hangchengliu/wake-sleep-box/ESP32S3 Korvo 2 V3开发板介绍 酷世DIY.md

# ESP32S3 Korvo 2 V3开发板介绍 酷世DIY

# [一、硬件简介](https://icnynnzcwou8.feishu.cn/wiki/IB7Gw8iQmi38vskElv6cDtHJn3c)

文档教程：<https://github\\.com/Kevincoooool/esp\\-idf\\-docs>

<https://gitee\\.com/Kevincoooool/esp\\-idf\\-docs>



除此之外每个例程的readme.md文档也可以看看

开发板3D文件和外壳3D文件：

[KS_S3_KORVO_V4.step]

[Korvo上盖.stl]

[Korvo下盒子.stl]

开发板介绍视频：

[VID_20260630_152118.mp4]

# 二、必看编译过程！！！！

# [Windows搭建 ESP IDF 5.3.2开发环境以及编译小智](https://icnynnzcwou8.feishu.cn/wiki/JEYDwTTALi5s2zkGlFGcDiRknXf)

Korvo板烧录小智固件可以选1.9.4稳定版 或者最新的2.2.3以上

官方固件：<https://github\\.com/78/xiaozhi\\-esp32/releases/download/v2\\.2\\.6/v2\\.2\\.6\\\_esp32s3\\-korvo2\\-v3\\.zip>



烧录固件的工具：

[esp32-flasher.exe]

查看运行日志的工具：

[ESP32串口助手.exe]

以下是带小智摄像头预览的固件，唤醒词是小白小白：

[merged-binary.bin]

如果遇到无法下载的情况请安装驱动：

Mac版驱动:

[CH341SER_MAC.ZIP]

Windows版驱动：

[CH341SER.zip]

音频对讲例子：<https://github\\.com/espressif/esp\\-adf/tree/release/v2\\.x/examples/protocols/esp\\-rtc>

> # [AI对话例程](https://icnynnzcwou8.feishu.cn/wiki/PPvrwrTCRi4U5PkKzEUc0qT3nre) 虾哥的小智AI
>
> # 改唤醒词参考：[关于唤醒词更改及配置操作步骤](https://rcnv1t9vps13.feishu.cn/wiki/H4dywK6ucigEtykKmm3cmZ7Dnog)
>
> # [需要使用参考小智AI百科全书](https://ccnphfhqs21z.feishu.cn/wiki/F5krwD16viZoF0kKkvDcrZNYnhb)

> 鼠标悬浮在空白行左侧，点击“**+**”插入“**信息收集**”小应用。[了解更多](https://www.feishu.cn/hc/zh-CN/articles/490019170235?from=in_ccm_template_docs)
