hangchengliu/wake-sleep-box/HACK For LIFE｜WTCC参赛指南·硬件篇.md

# HACK For LIFE｜WTCC参赛指南·硬件篇

> 选手阅读稿 ｜硬件篇 · 2026年10月18日。根据组委会宣发稿、已确认事项、物料图片、TiDB技术资料及官方文档整理；当前先完成本地硬件篇。现场提供设备按组委会清单列明；每队借用分配及其他未列明的赛事安排另行补充。除明确标注的规定外，本文中的技术建议不等于比赛强制要求。

**联合赞助伙伴｜TiDB**

感谢TiDB为本次活动提供资金与硬件支持。活动提供TiDB SDK及配套接入资料，参赛开发环境默认按接入TiDB能力准备。请各队将SDK安装或接入验证列入开工步骤，再围绕自己的生活场景开发功能。本文沿用活动“TiDB SDK”的称呼；具体软件包、版本与安装位置以现场适配教程为准。

**特别感谢以下造物伙伴**

地瓜机器人

进迭时空

拓竹科技杭州西湖文三路授权专营店

## 出发前，先看这六件事

1. **时间地点：** 10月22—25日，上海西岸国际会展中心；每队2—4人。
2. **我们提供：** X5、Pico- ITX、ESP32相关硬件、STM32套件、USB摄像头，以及打印和装配资源，详细数量见下一张设备表。
3. **你要带：** 笔记本和充电器；使用开发板本地桌面时，自带显示器、键盘、鼠标及显示线和电源。现场没有显示器和键鼠。
4. **建议先选定开发板，完成开发环境配置，再接入 TiDB SDK。硬件选型时，请综合考虑功能需求、硬件成本与实际效益。：**TiDB SDK安装/接入验证参考[TIDB 使用以及案例文档](https://feishu.doubao.com/wiki/DkW6woXxfidrd7knLQDcrF25nbe)；再按视觉、板端AI或动作控制需求阅读对应板卡章节。
5. **现场禁止焊接：** 需要焊接的部分赛前完成，现场采用免焊连接。
6. **每天18:00闭馆：** 不提供住宿；带离硬件须登记获准，打印机等公共设备留在现场。

## 活动速览

**HACK For LIFE，用AI，重新设计人的一生。** 2026年10月22—25日，在上海西岸国际会展中心，用四天做出一个可以运行、可以触摸、可以现场演示的AI硬件原型。

可以个人报名，提前组队或在选手群、现场寻找队友；每队2—4人。可以带已有设备、代码、设计文件或半成品参赛，报名时须如实说明赛前完成情况；评审关注比赛期间完成的有效增量，成熟产品评奖资格以正式规则为准。

| 赛道 | 关注的问题方向 |
|-|-|
| BEGIN｜生命初启 | 孕育、儿童成长、学习教育、亲子与创造力 |
| LIVE｜正在生活 | 成年后的工作、家庭、社交、兴趣、创作与出行 |
| BLOOM｜人生再启 | 退休后的再学习、兴趣、运动、社交、陪伴与第二人生 |
| BEYOND｜数字生命 | 记忆与数字遗产、数字分身、代际传承、纪念与数据权利 |

赛道帮助你选择生活问题，硬件根据项目需要选择，不按某一家赞助商划分赛道。涉及儿童、健康或逝者资料时，应取得相应授权并尊重数据权利。

### 四天怎么推进

- 第一天：先进入WTCC展馆观察真实使用场景，中午回四楼整理观察、选择具体问题；下午确定赛题、组队并开始制作。
- 第二、三天：制作、联调、测试和删减功能，优先保留关键体验。详细时间表待公布。
- 第四天下午：Demo Day，实物展示并接受现场使用检验。具体报到、提交和展示时刻待公布。

### 每天离场前

场馆每天18:00闭馆，不提供住宿。闭馆后可带个人设备及**经登记允许外借**的硬件套件在场外继续开发；3D打印机等公共设备不得带离。离场前备份代码和模型、记录启动步骤，按工作人员要求处理打印任务与设备电源。

活动期间每天提供中餐

零食、饮料和矿泉水不限量供应。

项目可通过Opendev API Key使用主流模型；领取入口、模型清单与调用限制仍需组委会补充，不等于无需账号或任何并发均可使用。

## 1. TiDB联合赞助开发支持｜SDK与硬件Agent接入

[TIDB 使用以及案例文档](https://feishu.doubao.com/wiki/DkW6woXxfidrd7knLQDcrF25nbe)

## 我们提供哪些设备

现场准备了开发板、摄像头、传感器与执行器、3D打印设备，以及原型装配工具。你可以按项目需求申请使用，项目不可替代的核心元件建议自行携带。

**下表为组委会提供的设备与物料，总量不是每队配额。** 按项目需求申请使用，申请方式和每队配额另行公布。

### 开发板与智能硬件

| 我们准备的设备 | 当前清单数量 | 适合做什么 | 配套与使用说明 |
|-|-|-|-|
| A 板:ESP32-S3 Korvo 2V3开发板+四路舵机驱动板(感谢TiDB赞助) | 8套 | 语音交互机器人、桌面AI助手、可动装置;可结合传感器和舵机，实现感知、对话与动作联动。 | 配套四路舵机驱动板，可扩展舵机及传感器。可使用ailyBlockly图形化编程，或通过VS Code开发;结合Agent_link接入Agent，实现数据上报与指令控制。舵机需按实际型号配置供电与接线。 |
| B板:ROROLEE智能硬件(感谢TiDB赞助) | 10台 | AI语音伙伴、互动角色、随身语音助手等，适合以对话为核心的创意项目。 | 采用BLE语音方案，通过配套手机App与Agent通信。使用前需安装配套App、完成蓝牙连接及Agent 配置，也可自已开发接入TidbAgent平台或开发配套App |
| C板:微雪ESP32-S3-ePaper-3.97黑白墨水屏开发板(感谢TiDB赞助) | 6台 | AI桌面信息牌、电子工牌、日程与待办看板、文字回复展示、传感器数据看板。 | 原表主控名称“ESP32S31”待实物核对，屏幕规格与驱动待确认 |
| 14类传感器及交互模块(感谢TiDB赞助) | 每类5个，共70个 | 环境感知、人体与动作检测、压力与颜色识别，以及灯光、声音、遥控和旋钮交互，可组合制作智能装置。 | 包含薄膜压力、光照、气压温度、人体红外、红外测距、雨滴、蜂鸣器、RGB灯环、摇杆、六轴运动、颜色检测、红外遥控、旋转编码器、心率脉搏模块。选手可按创意选用一种或多种，连接前核对供电电压、接口和引脚。 |
| 地瓜机器人RDK X5开发套装  
（感谢地瓜机器人赞助） | 10套 | 摄像头识别、视觉交互、机器人感知 | 10个板卡10个电源10个SD卡；供电接法由设备台确认，借用后归还 |
| 进迭时空Pico- ITX（感谢进迭时空赞助） | 15套 | RISC-V板端AI应用与原型开发 | 15个开发板，15个 电源适配器+typeC |
| STM32F103C8T6入门套件 | 16套 | 传感器采集、灯光、舵机和电机控制 | 含最小系统板、下载器、USB转TTL及多类模块，按实际发放内容清点 |

### 摄像头、模块与电子配件

| 我们准备的物料 | 提供数量 | 主要内容与用途 |
|-|-|-|
| USB摄像头 | 16个 | 720P无畸变、60°视角摄像头模组，USB连接，用于开发板视觉识别 |
| 传感器与输入模块 | 16套配套模块组（含在16套STM32套件内） | 光敏、热敏、红外、陀螺仪、旋转编码器、按键、电位器等 |
| 显示与输出模块 | 16套配套模块组（含在16套STM32套件内） | OLED、蜂鸣器、LED、SG90舵机、直流电机及驱动模块等；电机通过驱动与合适电源使用 |
| 连接与基础电子配件 | 16套配套材料（含在16套STM32套件内） | 面包板、杜邦线、跳线、电阻、鳄鱼夹等，采用免焊连接 |

上述三类模块和配件是同一批16套STM32套件的组成部分，不另加为48套独立设备；每套散件数量按套件配置。

### 3D打印与装配工具

| 我们提供的资源 | 数量或配置 | 用途与规则 |
|-|-|-|
| 3D打印机 | **共5台：**  
2 台A1  
1 台X2D  
1 台P2S  
1 台H2D | 共享制作外壳、支架和原型零件，公共设备不可带离场馆 |
| PETG打印耗材 | PETG囤货版，3套，每套10卷，共30卷 | 供现场3D打印使用，由打印工位安排 |
| 3D工具套装 | 16套，得力水口钳＋尖嘴钳等模型处理工具 | 打印模型修整与装配使用 |
| 得力热胶枪胶棒套装 | 16套，每套40W至尊胶枪＋30根胶棒 | 用于原型粘合固定，避免烫伤 |

**现场禁止焊接。** 如需焊接排针、连接器或其他部件，请在到场前完成。

### 3D打印如何排班（拟定流程，发布前由组委会落实）

5台打印机由打印工位统一管理，采用任务登记与排队使用；不按固定“几队一台”分配，也不让队伍长期占机。以下为本稿拟定流程，登记渠道与负责人确定后发布执行。

1. 队伍提交名称、联系人、模型文件、尺寸、数量、用途和期望完成时间；建议附预览图。
2. 打印负责人检查模型、材料和切片，估算用时后安排机器与时段。优先打印验证核心功能的小件，大件或长任务与负责人协商拆分。
3. 记录排班与任务状态，队伍按通知取件、试装；修改或重打重新登记，不直接覆盖其他队伍任务。
4. 临时取消及时告知，空出的时段继续安排排队任务。每日18:00闭馆前由负责人确认任务和断电安排，跨闭馆打印不得自行决定。

登记入口、文件格式要求、单次任务时长与材料限制由组委会另行公布；不承诺提交后立即开打或固定交付时刻。

### 现场设备之外，你需要带什么

建议每队自带**笔记本电脑、充电器、显示器、键盘、鼠标和对应线材**。X5准备HDMI连接，K3准备DP连接；显示器也要带电源。**现场不提供显示器、键盘和鼠标，请自行携带。**使用ROROLEE标准路径还需兼容手机。详细清单见第6节。

如果对网络有较高需求可带扩展坞，场地也支持网线联网

模型API及TiDB Agent Stack等属于软件服务资源，领取方式与权限另行说明，不计入硬件套装。

## 3. 第一次参加，先看这一段

你需要做的是：围绕一个具体问题，做出能现场演示的作品。先让一个核心功能跑通，再增加外壳、动作和界面。

例如：摄像头看到物体 → 开发板完成识别 → 页面展示识别结果；如果需要动作，再加 STM32 或 ESP32 控制舵机；通过TiDB SDK及配套服务接入Agent能力，按需增加工具调用、状态与记忆。

设备不是越多越好。新手建议从“一块主力板 + 一个输入设备 + 一个可见结果”开始。可以携带已有设备参赛；默认按接入TiDB SDK的路径开发；自带硬件同样需要安排接入验证。自带设备登记细则另行说明。

## 4. 我该选哪一套

| 你的作品主要做什么 | 建议从什么开始 | TiDB SDK接入路径 | 先跑通什么 |
|-|-|-|-|
| 语音或联网交互 | TiDB赞助的ESP32-S3相关设备 | 按对应固件、App与SDK教程连接Agent Stack | 一次真实输入→Agent处理→设备反馈 |
| 信息展示与陪伴交互 | TiDB赞助的Rorolee或彩色墨水屏套装 | 按设备开放能力，通过配套App或中转程序接入 | 输入事件后显示或播报一次结果 |
| 摄像头识别、视觉交互 | 地瓜RDK X5＋USB摄像头 | 在板端或电脑端中转环境接入SDK，按适配教程安装 | 摄像头采集→Agent处理→屏幕显示 |
| RISC-V板端AI应用 | 进迭时空Pico- ITX | 先核对RISC-V依赖；采用兼容运行环境或电脑中转接入 | 板端应用运行，再完成TiDB联调 |
| 传感器、灯光、电机与舵机 | STM32入门套件 | STM32负责采集和执行，SDK部署在主控或电脑中转侧 | 传感器事件→Agent决策→灯光或动作 |
| 外壳、支架与固定件 | 3D打印服务＋装配工具 | 结构件服务于已选的TiDB硬件交互方案 | 先打印小尺寸验证件 |

### 选硬件时，也算一算成本

优先选择能完成核心体验、成本与开发难度合适的配置。简单按键、灯光和传感器控制可从STM32/ESP32开始；确需本地图像处理或板端AI时，再选择X5或K3。借用时不收取采购价，不代表作品未来量产没有硬件成本；借用费用政策另行说明。

建议队伍记录主板、传感器、执行器、屏幕、供电和结构件的成本，并区分核心功能必需件与可选件。赞助硬件建议售价正在收集，组委会后续提供参考价格表；当前不编造售价，也不把原表市场价格直接当成最终建议售价。

SDK的安装位置随硬件能力不同：Linux主控或电脑中转侧运行接入程序，ESP32等按配套固件与协议连接，STM32负责底层控制。默认接入TiDB不等于所有芯片直接安装同一个软件包。

## 5. STM32套件里有什么

套件共16套，下面按功能说明内部模块，方便选手选用。其他设备的型号与数量见前面的“我们提供哪些设备”。

- 控制与连接：STM32F103C8T6最小系统板、下载器、USB转TTL、面包板、跳线、杜邦线。
- 输入与感知：按键、电位器、光敏、热敏、对射红外、反射红外、旋转编码器、陀螺仪模块。
- 显示与输出：0.96英寸OLED、有源蜂鸣器、LED、电机驱动模块、直流电机与风扇叶、SG90舵机。
- 其他：W25Q64存储模块、电阻、鳄鱼夹、镊子、小螺丝批、收纳盒。

商品图中的“MU6050”等名称存在拼写疑点；模块型号、针脚和工作电压按到货实物及对应资料核对。不要按图片位置猜接线。

## 6. 来现场最应该带什么

**现场不提供显示器、键盘和鼠标。使用开发板本地桌面的队伍，请自带显示器、键盘和鼠标；推荐每队准备一套。** X5核对HDMI输入，K3核对DP输入；带好对应线材和显示器电源。便携屏只有USB-C接口时，须实测兼容，不能凭接口形状判断能显示。

笔记本电脑的HDMI接口通常用于输出，不能直接用一根HDMI线把笔记本当显示器。熟悉SSH的队伍也可远程操作，但初次配置、网络故障和本地图形调试时，独立显示屏会更方便。

### 每位负责开发的队员优先带

- [ ] 笔记本电脑和原装充电器；能正常安装依赖、运行代码，提前确认有安装权限。

- [ ] 能传数据的USB线；根据自己设备准备Type-C、USB-A或Micro USB，避免只带充电线。

- [ ] 鼠标；电脑接口较少时带USB扩展坞。

- [ ] 代码、模型、演示素材的本地备份；准备U盘或其他备份方式。

- [ ] 已登录且可用的开发账号；项目依赖云服务时提前验证网络和配额。

### 每队最实用的一包配件

- [ ] 网线；电脑没有网口时带USB网卡。

- [ ] 便携显示器或普通显示器、键盘、鼠标，以及显示器电源。

- [ ] 计划用X5直连显示器：确认HDMI线与显示器的HDMI输入接口。

- [ ] 计划用K3直连显示器：确认DP线或经过验证的DP转接方案；不能默认HDMI线可直插。

- [ ] 使用ROROLEE标准方案：兼容手机、充电器和数据线；提前确认App安装、蓝牙连接与网络可用。

- [ ] 绝缘胶带、扎带、标签纸、小螺丝批、少量固定螺丝与铜柱。

- [ ] 若作品有机械动作：对应电机/舵机、驱动器、经过确认的独立供电、急停或断电方式。

- [ ] 需要特殊传感器、专用镜头或特殊结构件：先向组委会确认供应，再决定是否自带。

**不需要现在就购买另一块开发板或搬来打印机。** 先确认借用名额和项目需求。**现场不提供显示器、键盘和鼠标，请自行携带。** 排插安排及自带电池规则另行补充。**WTCC现场禁止任何形式的焊接作业。** 请使用杜邦线、面包板、接线端子等免焊方案；确需焊接的部分，请在到场前完成。电烙铁、焊锡丝、松香等焊接用品不列入现场工具准备清单。

## 7. 到场后，按这个顺序开始

1. 向设备台说明你的方案，确认借用设备和所需配件；拍照记录板卡、线材及外观。
2. 请工作人员确认电源、板型、系统版本、登录方式，给设备贴上队伍标签。
3. 暂时只接主板、必要的散热和网络，先确认能启动与登录。
4. 接入一个输入设备，验证原始数据。例如先看摄像头画面，不要一上来同时调识别和电机。
5. 先完成TiDB SDK安装/接入验证与第2节的首个演示，再替换成自己的逻辑。
6. 最后接入执行器、数据库和外壳，每增加一项就单独验证。

建议把“设备型号、系统版本、启动命令、账号由谁保管、演示步骤”放进队伍README，避免换一个人就不会启动。

## 8. 地瓜 RDK X5：从开机到第一个演示

[地瓜相关开发文档](https://feishu.doubao.com/wiki/OOaHwZTw3ioQDPkQzt9c3EbpnEe)

## 9. 进迭时空｜K3共建计划福利与Pico-ITX开发参考

[进迭时空｜K3共建计划福利与Pico-ITX开发参考](https://feishu.doubao.com/wiki/JiZ1wYWQjia5y5kbUPbcCg3nnNl)

## 10. STM32、摄像头和装配工具怎么开始

**现场禁止焊接。** 以下接线均应采用免焊方案，需要预先焊排针或连接器的模块请在赛前处理好。

[STM32型号以及开发相关](https://feishu.doubao.com/wiki/GeiXwoxTqitvapkjKWTcFffXn8g)

### 打印与固定：先能装上，再追求漂亮

现场共提供5台3D打印机：**H2D 1台、P2S 4台**，供参赛队伍共享使用。建议提前完成模型设计并尽早提交打印需求，预留排队、试装和修改时间。

先量板卡孔位和镜头位置，设计薄壁小样确认尺寸。向打印服务提交模型、尺寸、材料需求和用途；排队与交付时间由设备台确认。打印前要检查PETG、实际打印机、料盘和切片参数是否匹配，不能凭图片默认耗材适合全部机器。

模型冷却后再取件、去支撑；刀具朝远离手的方向操作。胶枪按实际胶棒口径装料，放稳支架，按说明预热后使用；不强推未熔胶棒，不触碰喷嘴，不把胶挤到带电线路、连接器或散热部位。使用后断电并冷却。

## 11. 出问题时，先看这里

| 现象 | 先查什么 |
|-|-|
| 开发板反复重启 | 配套电源和线材是否正确，是否接错供电口；暂时拔掉非必要外设 |
| SSH连不上 | 板是否启动、IP是否正确、电脑是否在可互通网络；由设备台协助确认网络隔离问题 |
| 摄像头没有画面 | 先换到电脑测试，再查USB设备与视频节点；关闭占用相机的程序，降低分辨率 |
| 模型能加载但很慢 | 是否用了板端支持的运行时和模型格式，是否实际使用加速；先对照官方基准示例 |
| TiDB连接超时 | 主机和端口、网络可达性、实例状态与访问配置 |
| TiDB认证或TLS失败 | 用户名是否完整、密码是否正确、证书路径和系统时间是否正确；不要通过关闭验证绕过 |
| 舵机一动系统就掉电 | 电机供电是否独立且足够、接线是否正确、有无短路；断电后检查 |

求助时一起提供：队伍名、设备型号、想做什么、最后一次成功步骤、完整报错、当前接线照片。密码和令牌打码。

## 12. 展示前与归还前

宣发稿列出的评审关注点是：问题是否真实、核心功能能否运行、AI与硬件及交互是否形成完整体验、比赛期间完成的有效增量、是否值得继续验证。四条赛道分别产生一支Track Winner，再进入Grand Prize总评；详细评分权重和评选办法待正式规则公布。

以下是方便演示的建议清单；正式提交格式、时长和截止时间仍待公布，不沿用TiDB PDF的提交要求。

- [ ] 一句话讲清作品解决谁的什么问题。

- [ ] 按README可以从头启动一次，演示一个完整流程。

- [ ] 保留代码、依赖版本、接线图、模型与数据来源说明。

- [ ] 准备一段演示视频，作为网络或现场故障时的补充。

- [ ] 展示前检查电源、结构固定和动作范围。

- [ ] 归还前备份个人文件，按设备台要求退出账号、移除凭据并处理个人数据；清点板卡、电源、存储卡和线材，不自行重刷借用设备。

## 13. 活动信息卡

| 信息 | 当前说明 |
|-|-|
| 活动名称与主题 | HACK For LIFE，用AI，重新设计人的一生 |
| 比赛日期 | 2026年10月22—25日 |
| 地点 | 上海西岸国际会展中心；具体签到入口、楼层路线与入场凭证待补充 |
| 报名截止 | 宣发稿为10月17日；截至本稿日期已过，不默认仍可报名，补录安排待确认 |
| 队伍人数 | 每队2—4人，可个人报名后在选手群或现场组队 |
| 自带设备与已有原型 | 允许带入；报名时如实说明赛前完成情况，登记细则待补充 |
| 设备分配与签领 | 申请入口、每队配额、押金或签领方式待补充 |
| 显示器与键鼠 | 现场不提供显示器、键盘和鼠标，请自行携带；X5准备HDMI链路，K3准备DP链路 |
| 网络与电源 | 网络接入及排插安排另行补充 |
| 打印机 | H2D 1台、P2S 4台，共5台，共享使用 |
| 现场焊接规定 | 禁止任何形式的焊接；需要焊接的部分赛前完成 |
| 场馆与住宿 | 每天18:00闭馆，现场不提供住宿 |
| 场外开发 | 可带个人设备和登记允许外借的硬件套件；公共设备不得带离 |
| 餐饮 | 每天中餐，零食、饮料和矿泉水不限量供应 |
| 模型资源 | 宣发稿说明开发测试Token不限量；API Key领取与使用细则待补充 |
| 奖励 | 宣发稿为现金5万元以上，另设总额7万元Token额度；分配与领取条件待公布 |
| Demo Day | 第四天（10月25日）下午；具体时刻与提交要求待公布 |
| 评审 | 五项关注点见第12节；各赛道Track Winner进入Grand Prize总评 |
| TiDB资料中的赛道规则 | 不纳入WTCC，仅参考技术内容 |
| 支持与归还 | 技术支持位置、联系人、打印接单、归还时间待补充 |
| 知识产权 | 宣发稿拟定为团队原创成果归参赛队，原有技术与数据权利归原权利人；最终以正式规则为准 |

QA

1. 是否可以焊接？

场馆内消防要求不允许，场馆外可以，请注意安全

主办方：西岸集团、模速空间、Z·Pilot。承办方：AI Builder Lab·上海AI工坊。其他伙伴及评委导师名单以最终公布为准。
#（注：内容由AI生成）
