hangchengliu/wake-sleep-box/walkthrough.md

# 🌙 Wake 睡眠环境守夜盒 · 功能落地与全流程验证

## 一、 项目背景与产品核心卖点
- **痛点**：传统穿戴（Apple Watch / Oura / Whoop）测的是人（心率、体动），却测不到环境。睡眠卫生很大程度取决于卧室环境（噪音冲击、温差、漏光、起夜）。
- **Wake 盒子的定位**：专注卧室环境的床头守夜盒。整夜被动守夜、硬件断电零光污染；早晨用一句话告诉你昨晚为什么没睡好。
- **与穿戴互补**：手表测到你凌晨 03:18 醒了，Wake 告诉你是因为 03:15 窗外有 64dB 噪音，彻底形成因果闭环。

---

## 二、 落地实现的全部功能清单

### 1. 🟢 今天能做（Today）全部交付
1. **真·零光污染硬件级熄屏**：
   - 关灯或点击「开始守夜」（按键 `K3`），通过 `TCA9554` 芯片切断屏幕背光供电，实现物理 0 Lux 真正全黑。
2. **四维环境被动守夜监测引擎**：
   - **噪音冲击**：板载 `ES7210` 双麦克风持续计算声压分贝，捕获 $>55\,\text{dB}$ 突发噪音（仅存包络与峰值，严守隐私不录音）。
   - **夜间漏光**：`BH1750` 捕获 $>10\,\text{lx}$ 异常光污染。
   - **无感起夜**：`PIR` 捕获夜间离床活动，触发时 `WS2812` 仅点亮 1 颗微弱暖黄琥珀光（不影响褪黑素）。
   - **室温漂移**：`SPA06` 追踪整夜温度区间，统计越界舒适区（$16\sim25\,^\circ\text{C}$）时长。
3. **早晨环境健康评分（0~100 分）与一句话痛点归因**：
   - 算法自动计算四大维度扣分项，一针见血输出第一痛点建议（如：*“主因：夜间突发噪音 建议关紧窗户”*）。
4. **5 页平滑滚屏多功能面板**：
   - `1/5 Wake睡眠盒`、`2/5 麦克风声谱`、`3/5 喇叭音效台`、`4/5 板载六按键`、`5/5 外接传感器自动在位检测`。

### 2. 🟡 明天能做（Tomorrow）已提前全部实现！
1. **AI 晨间真人自然语音播报（Web Speech API）**：
   - 清晨唤醒后，自然人声自动朗读：*“早安，刘航成、夏工！昨晚你的卧室睡眠环境健康得分为 XX 分。整夜监测到 X 次突发噪音，最高达 XX 分贝；夜间漏光 X 次；起夜 X 次。AI 环境诊断建议：……”*
2. **Apple Watch 睡眠周期 × Wake 卧室环境 交叉印证双层时间轴**：
   - 直观呈现手表上的清醒尖峰（03:18）如何被 Wake 盒子的环境噪音（03:15 64dB）所触发。
3. **睡前助眠白噪音电台（Web Audio API 实时算法合成）**：
   - 纯代码算法实时合成：雨夜轻抚（Pink Noise）、深海潮汐（Wave LFO）、温暖篝火（Warm Crackle），无缝循环无网络卡顿。
4. **清晨记梦本与 AI 梦境情绪解析（Voice Dream Journal）**：
   - 晨醒后一键口述梦境，AI 自动提取意象关键词、心理映射与睡眠修复度寄语。

---

## 三、 验证与演示指南

### 1. 在家测试（无传感器状态）
- 打开 [http://localhost:8765/ble_dashboard.html](http://localhost:8765/ble_dashboard.html)，连接蓝牙。
- 点击 **「🌙 开始守夜（熄屏）」**：板子屏幕彻底全黑，喇叭播放温柔催眠音阶。
- 敲击桌子或拍手（实时麦克风捕捉噪音），点击 **「🧪 模拟起夜」**、**「🧪 模拟漏光」** 注入事件。
- 点击 **「☀️ 早安 · 语音报告」**：屏幕渐亮恢复，喇叭奏响日出和弦，电脑音箱同时用中文自然人声播报完整的早安诊断！

### 2. 明天现场插上 4 个传感器
- 依照接线指南插上 `BH1750`、`SPA06`、`PIR`、`WS2812`。
- 固件无需重新烧录，自动热识别，插上即可转为纯物理真实采集！
