hangchengliu/wake-sleep-box/3d_models/mvp_form_a_angled_caddy.jpg

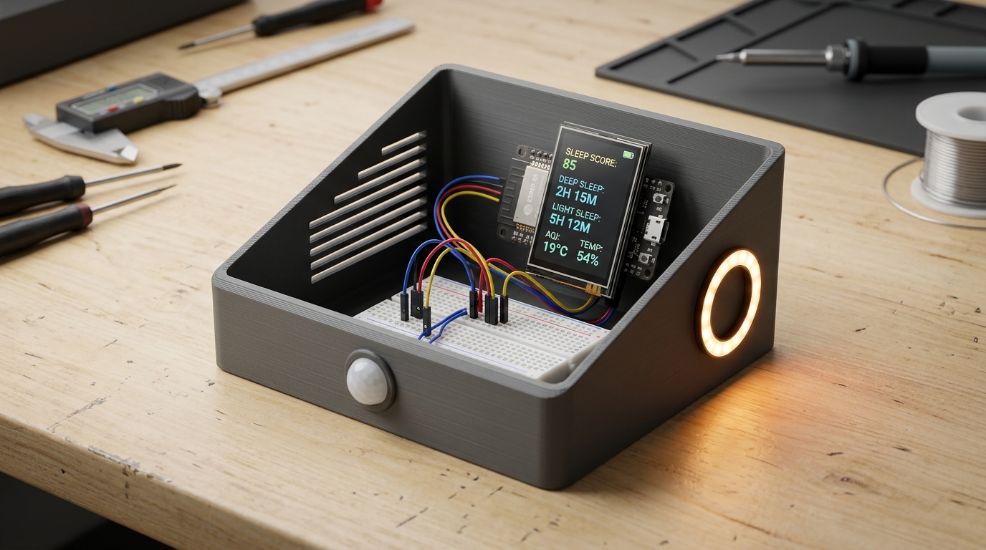
3d_models/mvp_form_a_angled_caddy.jpg
