hangchengliu/wake-sleep-box/3d_models/mvp_form_b_front_windowed.jpg

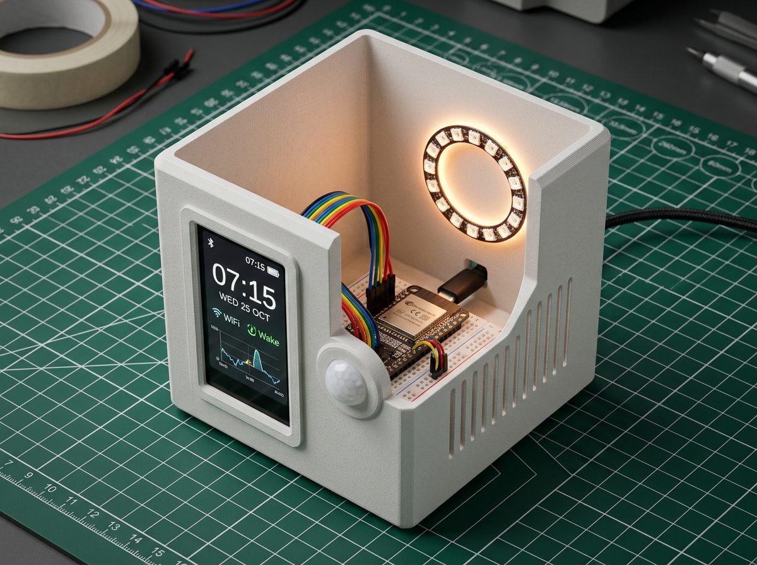
3d_models/mvp_form_b_front_windowed.jpg
