hangchengliu/wake-sleep-box/3d_models/scheme1_bedside_monitor.jpg

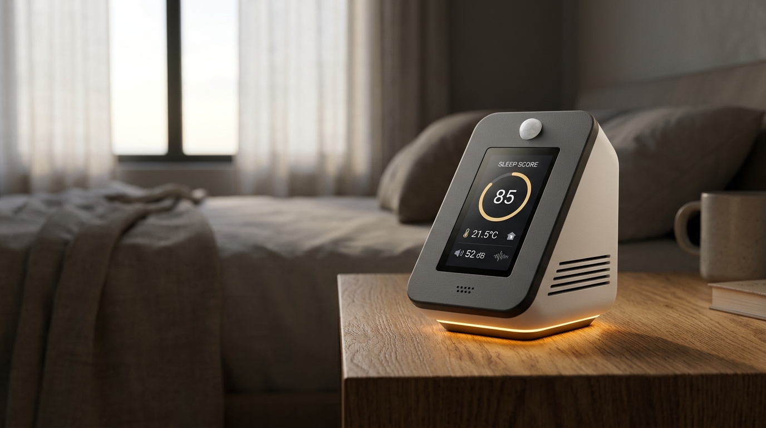
3d_models/scheme1_bedside_monitor.jpg
