hangchengliu/wake-sleep-box/3d_models/scheme2_cyber_tray.jpg

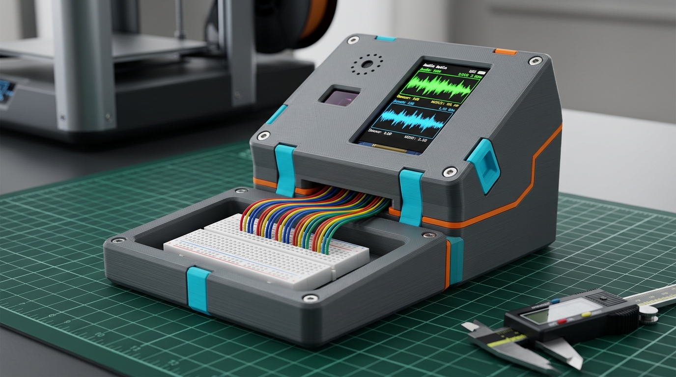
3d_models/scheme2_cyber_tray.jpg
