hangchengliu/wake-sleep-box/3d_models/scheme3_sleep_pebble.jpg

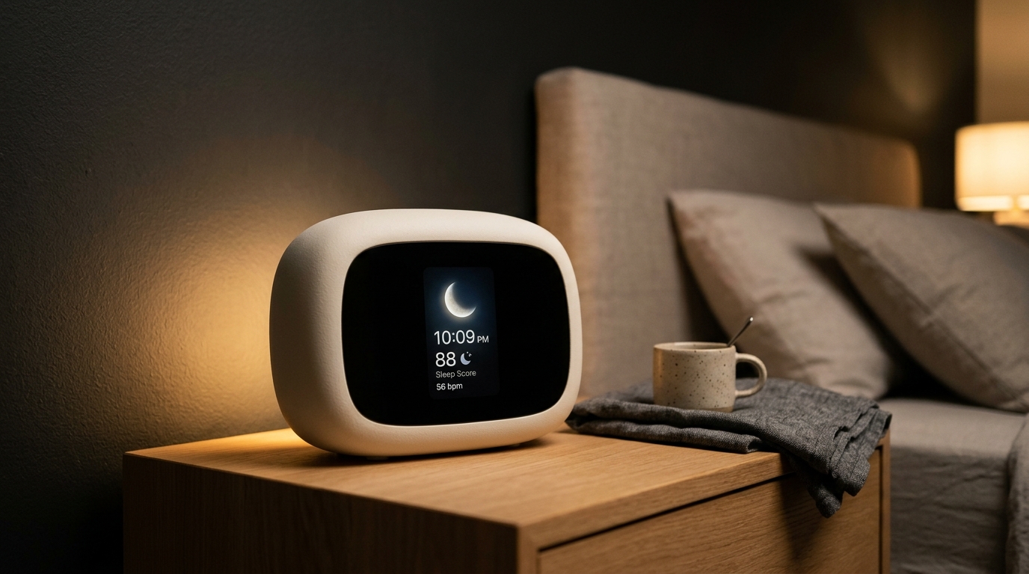
3d_models/scheme3_sleep_pebble.jpg
