hangchengliu/wake-sleep-box/3d_models/wake_meme_4_philosophies.jpg

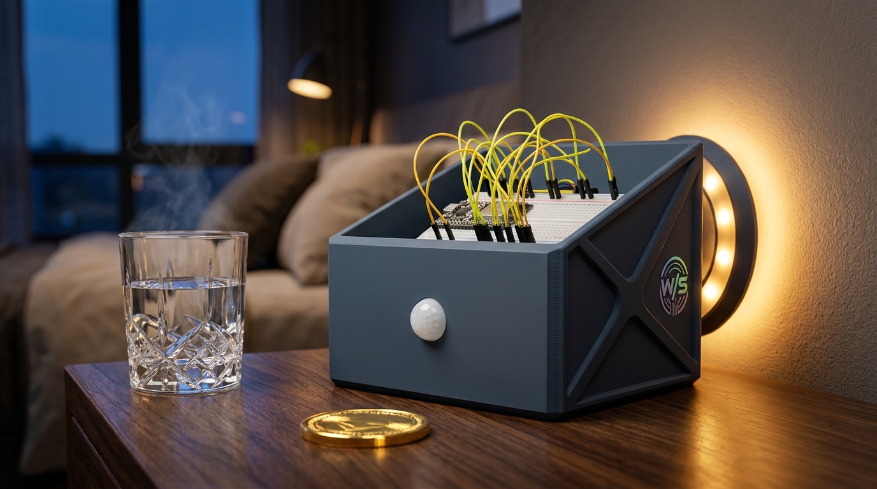
3d_models/wake_meme_4_philosophies.jpg
