hangchengliu/wake-sleep-box/3d_models/wake_meme_concept_trio.jpg

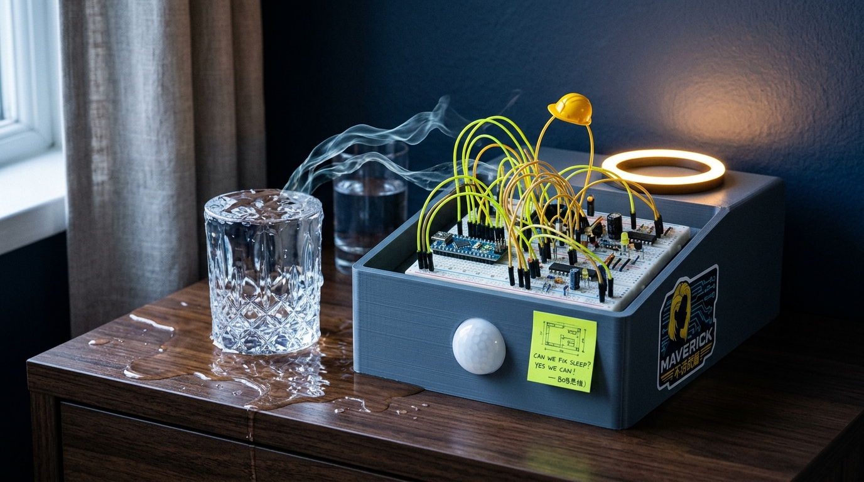
3d_models/wake_meme_concept_trio.jpg
