hangchengliu/wake-sleep-box/3d_models/wake_sleep_box_dream_hero.jpg

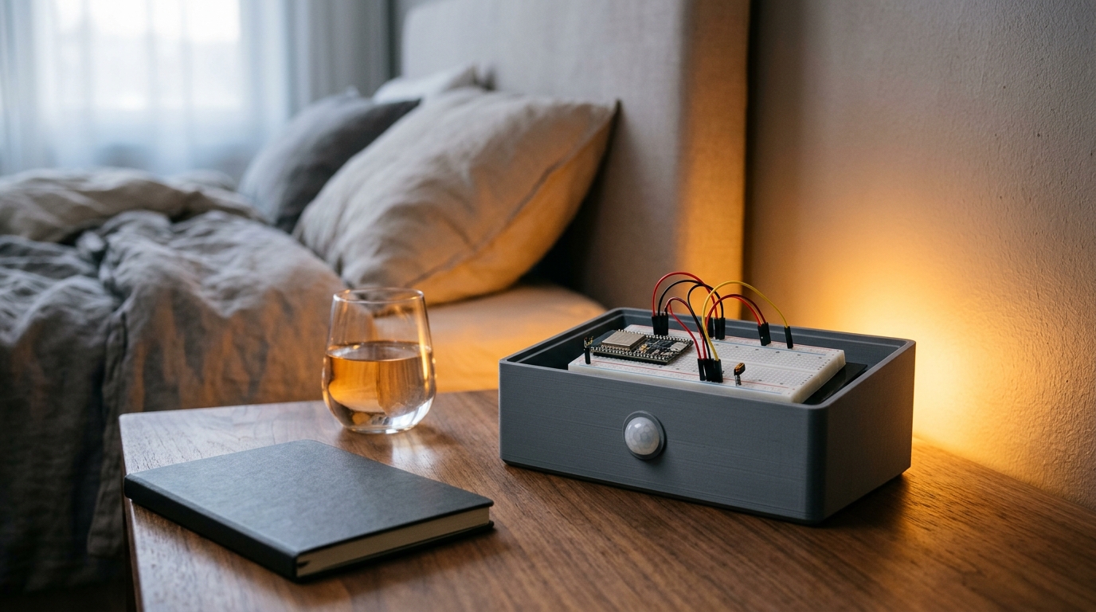
3d_models/wake_sleep_box_dream_hero.jpg
