hangchengliu/wake-sleep-box/3d_models/wake_box_top.stl

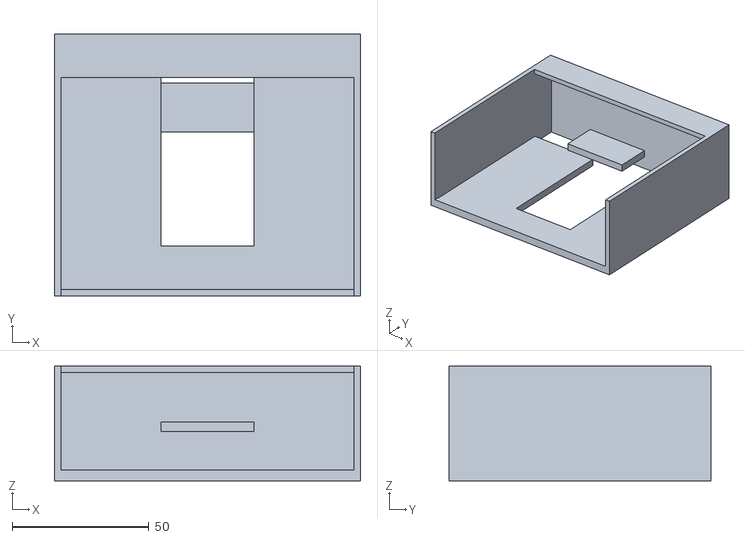
[picture p13: CAD file, 2026-10-25]
3d_models/wake_box_top.stl
112.0 x 96.0 x 42.0
