hangchengliu/wake-sleep-box/3d_models/wake_box_final_screenless.stl

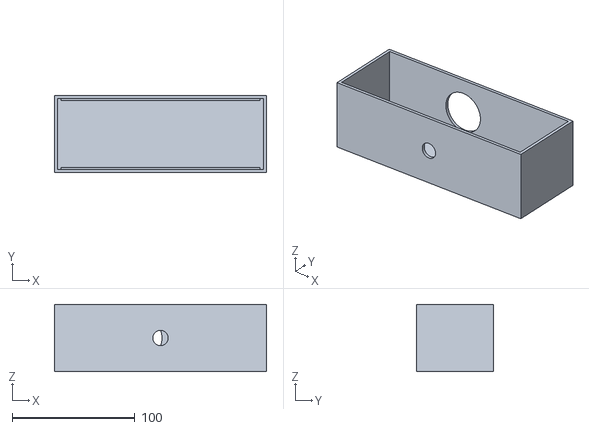
[picture p14: CAD file, 2026-10-25]
3d_models/wake_box_final_screenless.stl
172.8 x 62.8 x 55.0
