hangchengliu/wake-sleep-box/(commit log)

2026-10-23 feat: Initial commit for Project Wake (Ambient Sleep Hygiene & Bedroom Environment Monitor)
    - ESP32-S3 firmware with ST7789 5-page carousel UI, CST816S touch, ES8311 DAC, ES7210 mic ADC, and TCA9554 zero-lux backlight control
    - Multi-sensor sleep hygiene engine: noise RMS envelope, PIR nocturnal wakeups, BH1750 light leaks, SPA06 temp/pressure
    - Web Bluetooth dashboard with real-time telemetry, algorithmic white noise, speech AI morning debrief, and Apple Watch correlation
    - Dual-OTA non-destructive flashing tools protecting factory firmware
    - Comprehensive documentation, wiring schematics, and pitch script
    [display_name.ino, page_bitmaps.h, text_bitmap.h]
2026-10-23 docs: add comprehensive English README and enable bilingual navigation
    - Created README_EN.md with full architectural, hardware, and protocol specs
    - Added interactive English/Chinese language switchers at top of both READMEs
    - Added voice_relay service and updated .gitignore to safeguard local credentials
2026-10-25 feat(hackathon): complete full-stack delivery, voice relay, 3D enclosures and docs
    - Hardware & Firmware:
    - Add edge-native lightweight adaptive noise floor VAD (speech_detect.h)
    - Add onboard Wi-Fi voice chat client with BLE OTA provisioning (voice_chat.h)
    - Add WS2812 8-LED ring RMT driver with per-pixel and batch color control
    - Optimize dual microphone DC offset cancellation, fast attack & smooth decay
    - Cloud Voice Relay:
    - Add server.py with Whisper ASR, Cloudflare bypass UA, and auto retries
    - Add 60s circuit breaker for TTS outages with offline chime fallback
    - Add Traditional-to-Simplified Chinese mapping and silent hallucination filter
    - Ensure follow-up interaction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
    [wake_box_angled.scad, wake_box_bottom.stl, wake_box_final_screenless.stl, wake_box_form_b_165x55.scad, wake_box_form_b_165x55.stl, wake_box_modular.scad, wake_box_mvp_open.scad, wake_box_mvp_open.stl]
