hangchengliu/wake-sleep-box/(notices)

Notices in the files:
README.md:
License: MIT
